MrBlinky/tamadumper/arduino/arduino-dumper-1024.jpg

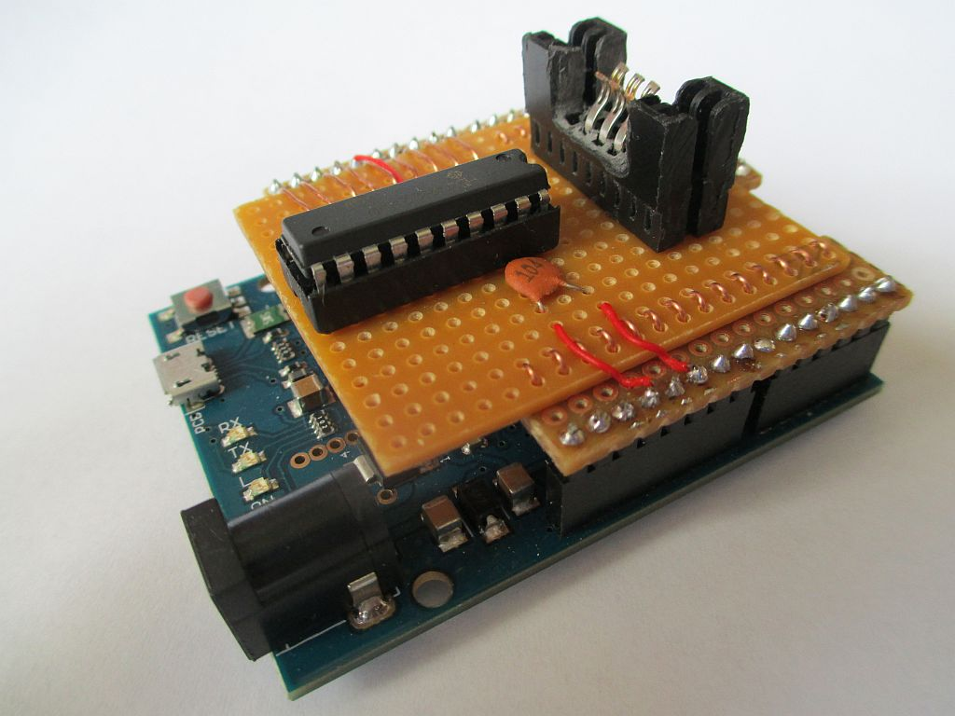
arduino/arduino-dumper-1024.jpg
