MrBlinky/tamadumper/lpt/dumper1-connector.jpg

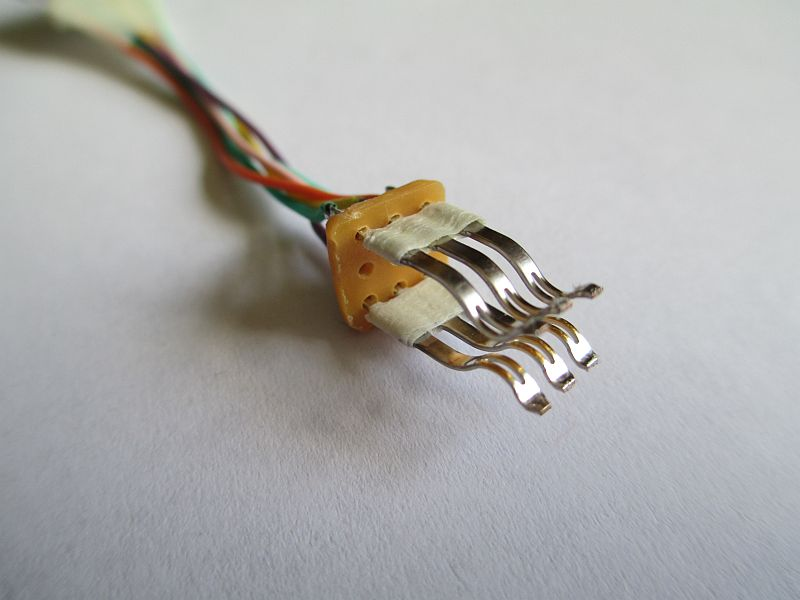
lpt/dumper1-connector.jpg
