MrBlinky/tamadumper/lpt/dumper2-pierce.jpg

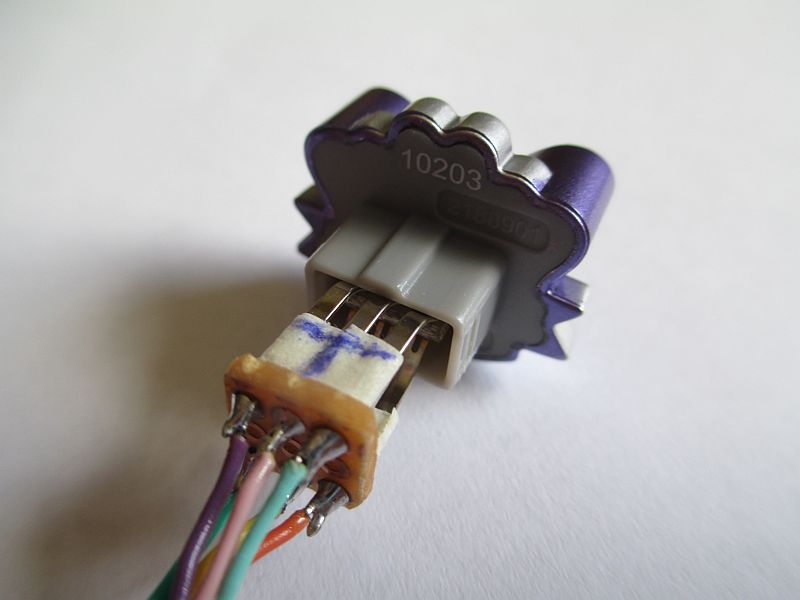
lpt/dumper2-pierce.jpg
