MrBlinky/tamadumper/lpt/dumper3-cable.jpg

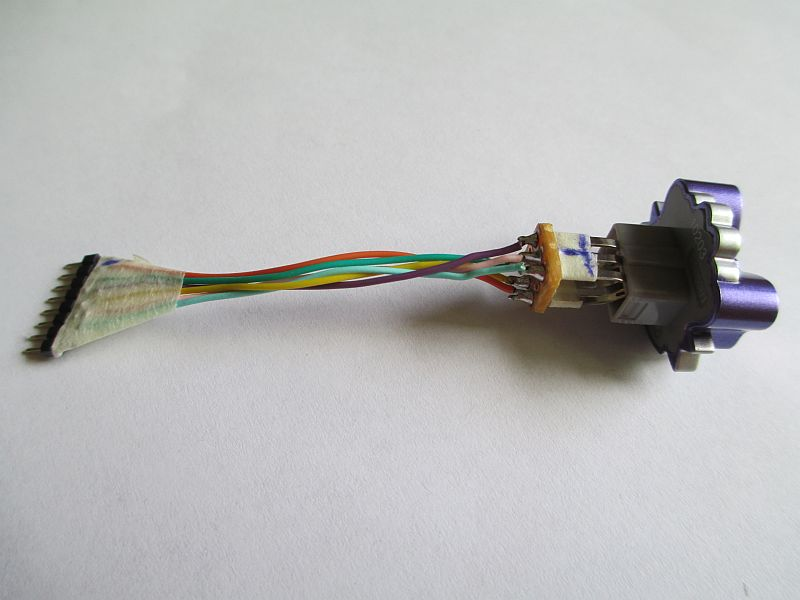
lpt/dumper3-cable.jpg
