MrBlinky/tamadumper/lpt/dumper4-programmer.jpg

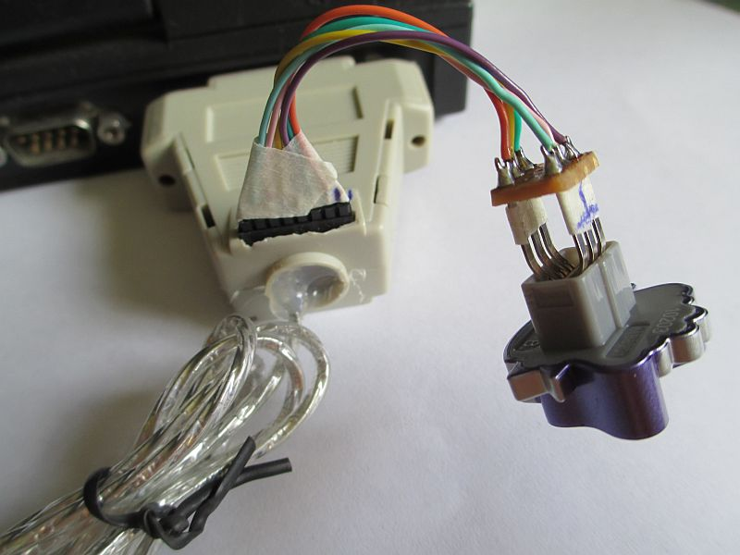
lpt/dumper4-programmer.jpg
