MrBlinky/tamadumper/lpt/dumper5-inside.jpg

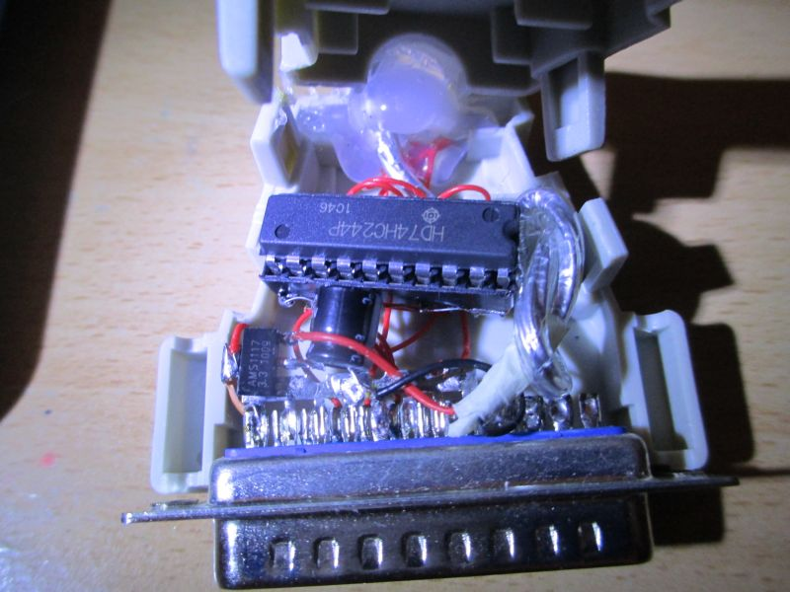
lpt/dumper5-inside.jpg
