MrBlinky/tamadumper/lpt/dumper6-newcon.jpg

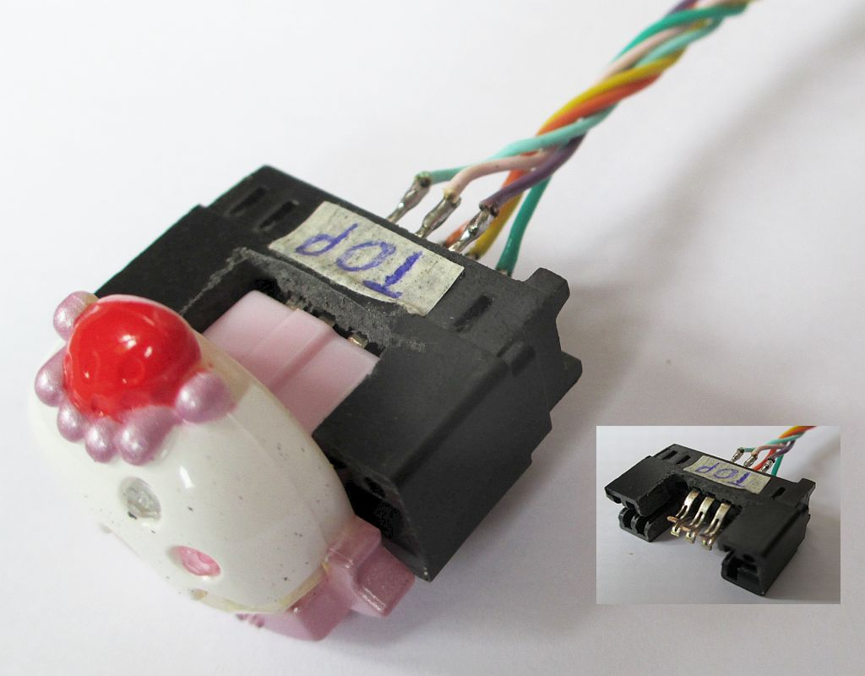
lpt/dumper6-newcon.jpg
