MrBlinky/tamadumper/lpt/TamaDecoDumper-LPT-1.1.pdf

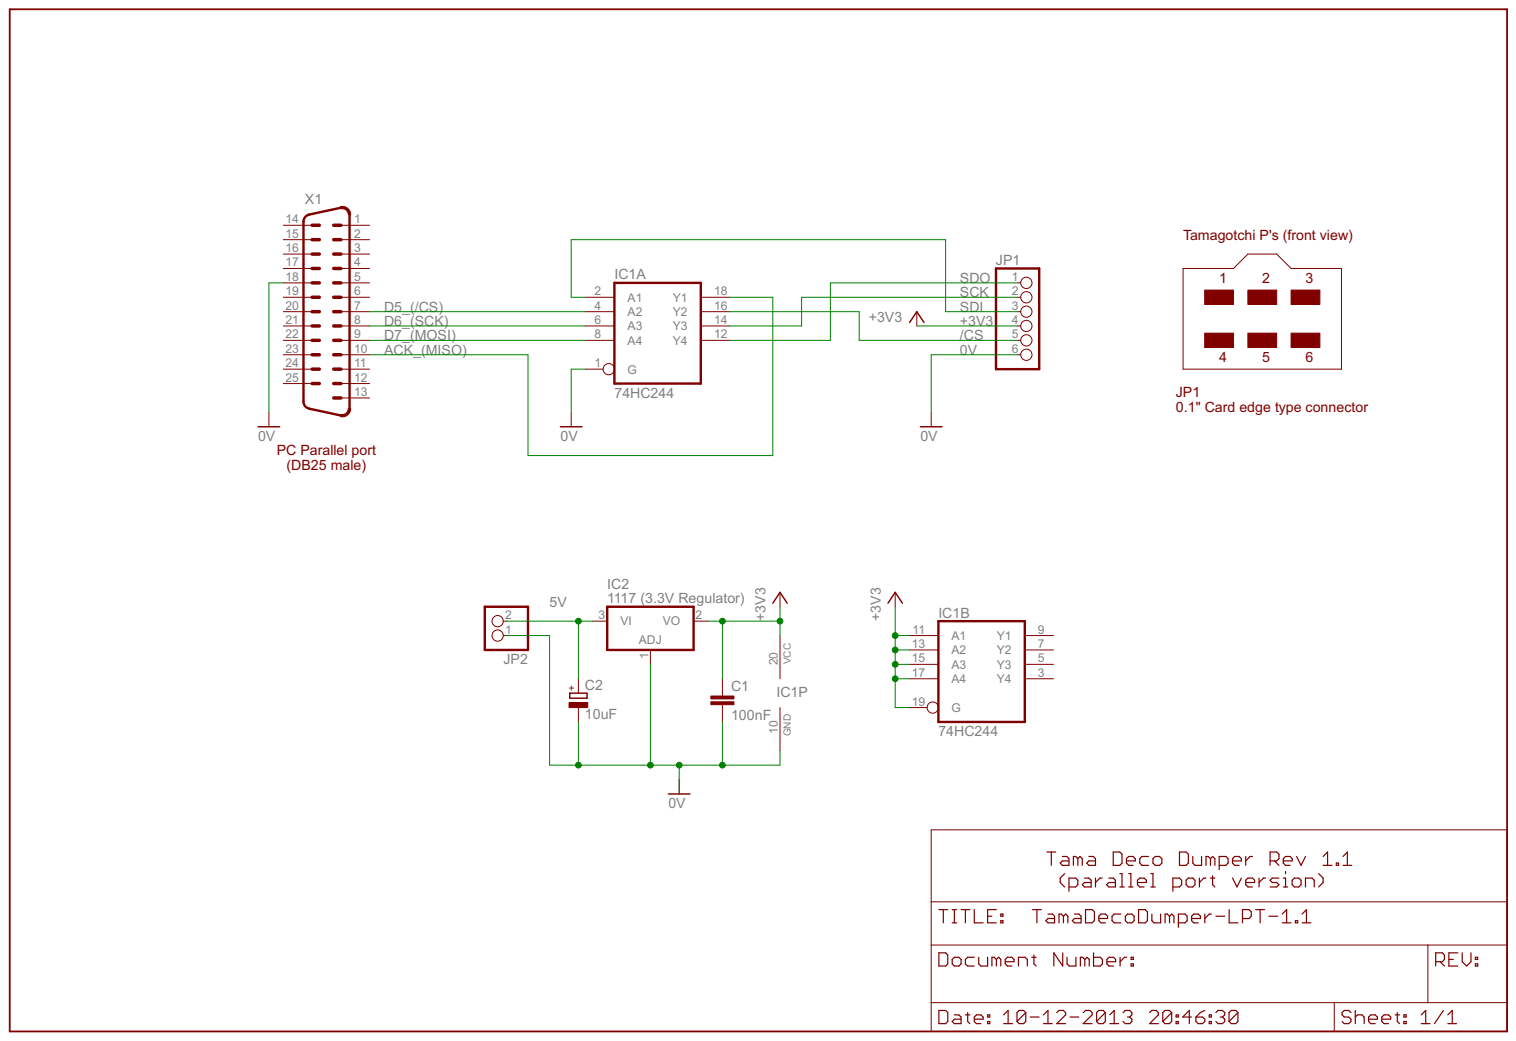
[picture p8: page 1]

0.1" Card edge type connector
