MrBlinky/tamadumper/lpt/TamaDecoDumper-LPT-1.1.sch

## EAGLE design lpt/TamaDecoDumper-LPT-1.1.sch (2014-02-03)

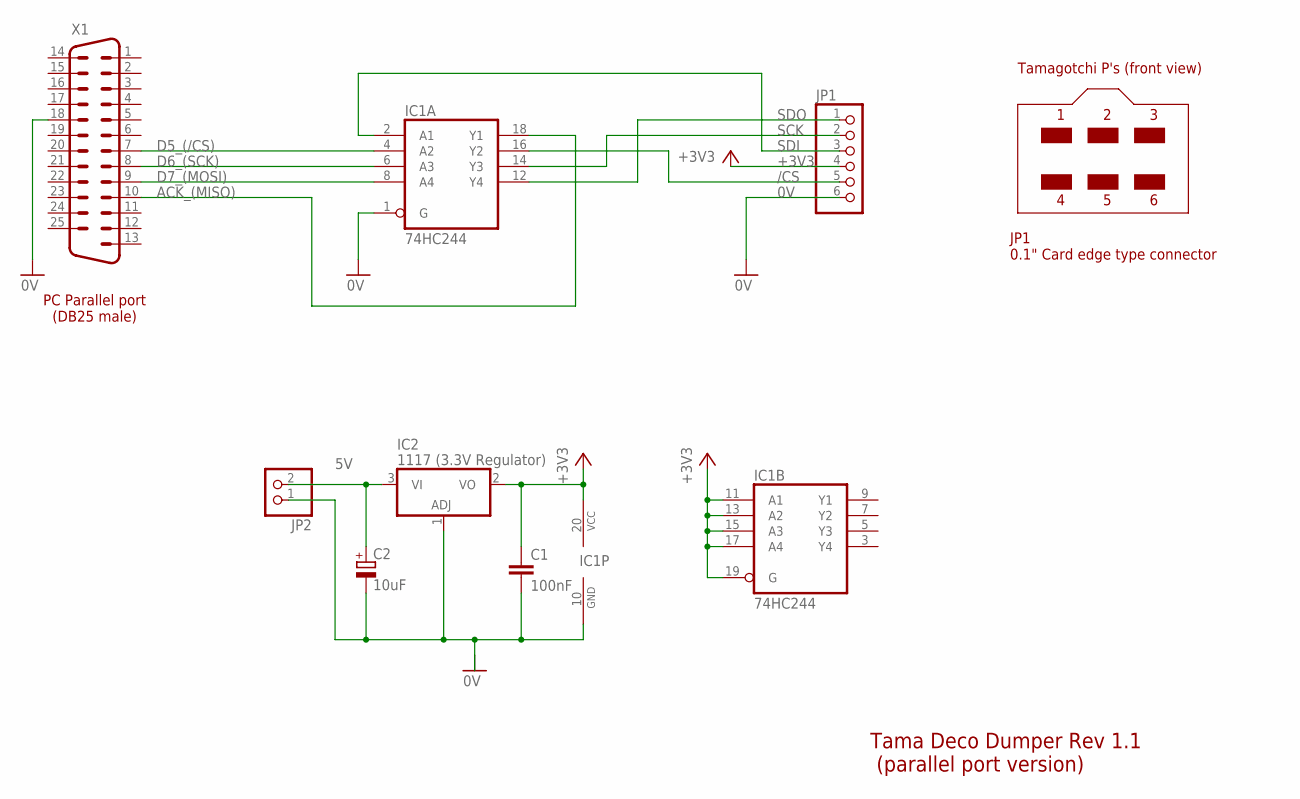
[picture p9: schematic TamaDecoDumper-LPT-1.1.sch]

Parts:
C1: 100nF; C050-025X075
C2: 10uF; E5-6
IC1: 74HC244; DIL20
IC2: 1117 (3.3V Regulator); TO220H
JP1: PINHD-1X6; 1X06
JP2: PINHD-1X2; 1X02
X1: M25HP

Connections:
0V: C1.2, C2.-, IC1.1 (G), IC1.10 (GND), IC2.1 (ADJ), JP1.6, JP2.1, X1.18
5V: C2.+, IC2.3 (VI), JP2.2
+3V3: C1.1, IC1.11 (A1), IC1.13 (A2), IC1.15 (A3), IC1.17 (A4), IC1.19 (G), IC1.20 (VCC), IC2.2 (VO), JP1.4
/CS: IC1.16 (Y2), JP1.5
ACK_(MISO): IC1.18 (Y1), X1.10
D5_(/CS): IC1.4 (A2), X1.7
D6_(SCK): IC1.6 (A3), X1.8
D7_(MOSI): IC1.8 (A4), X1.9
SCK: IC1.14 (Y3), JP1.2
SDI: IC1.2 (A1), JP1.3
SDO: IC1.12 (Y4), JP1.1

Notes on the sheet:
Tama Deco Dumper Rev 1.1 (parallel port version)
PC Parallel port (DB25 male)
Tamagotchi P's (front view)
JP1 0.1" Card edge type connector
