MrBlinky/tamadumper/(commit log)

2014-02-03 1st commit
    [TamaDecoDumper-LPT-1.1.sch]
2014-02-04 2nd commit
    Added erase function to arduino project, flash datasheet.
